josto-me/clutch-slip-monitor/hardware/cdi-rpm/cdi-rpm-layout.pdf

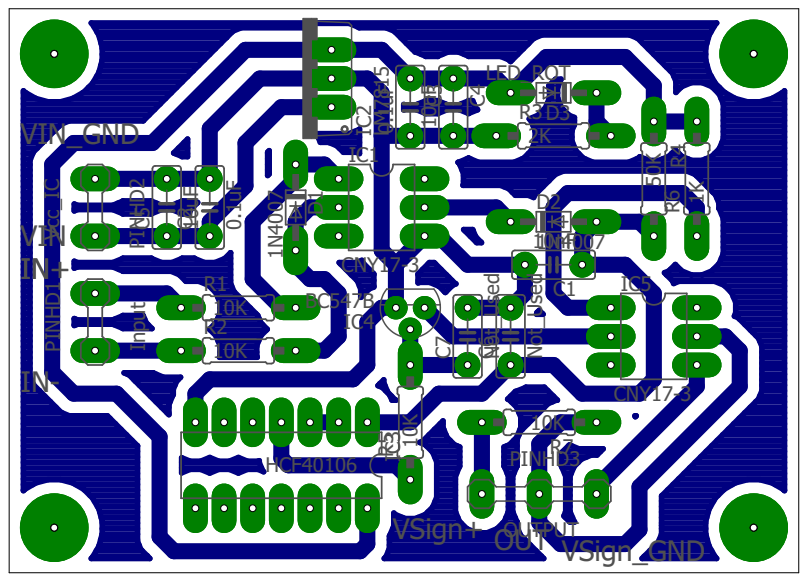
[picture p1: page 1]
