josto-me/clutch-slip-monitor/hardware/cdi-rpm/cdi-rpm-schematic.pdf

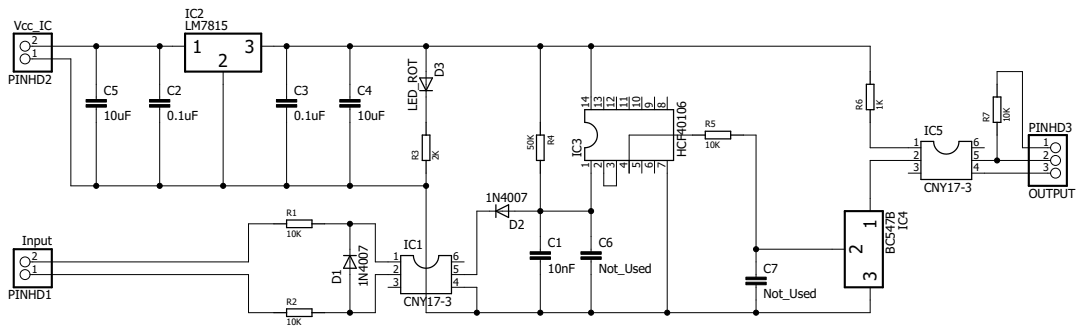
[picture p2: page 1]
