josto-me/clutch-slip-monitor/hardware/ignition-amplifier/ignition-amplifier-layout.pdf

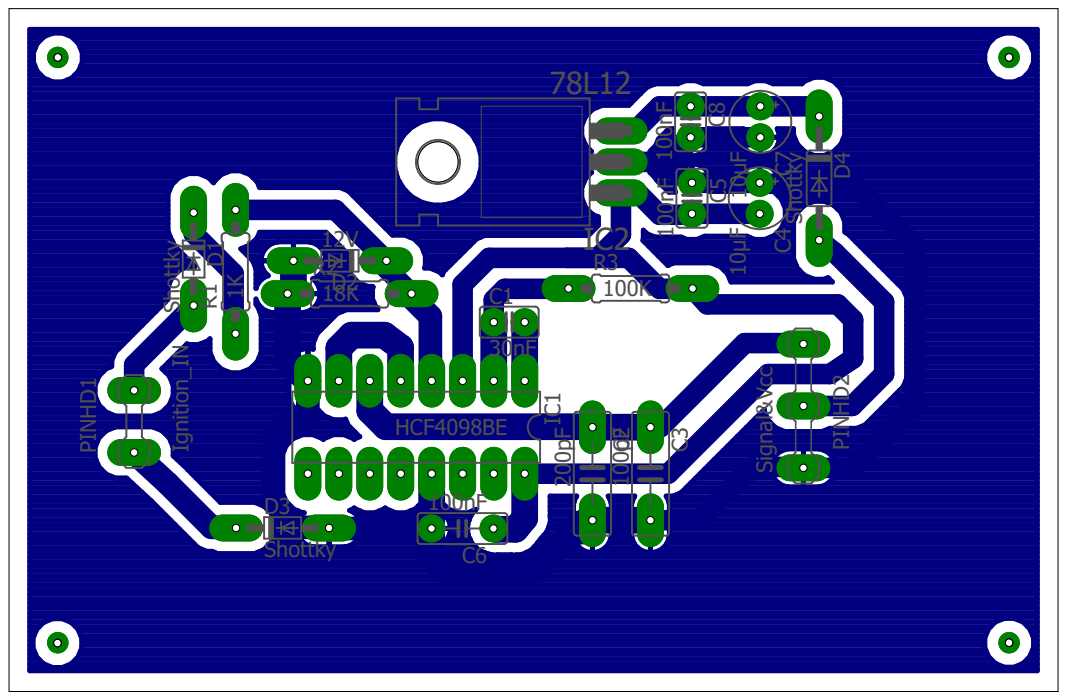
[picture p3: page 1]
