josto-me/clutch-slip-monitor/hardware/ignition-amplifier/ignition-amplifier-schematic.pdf

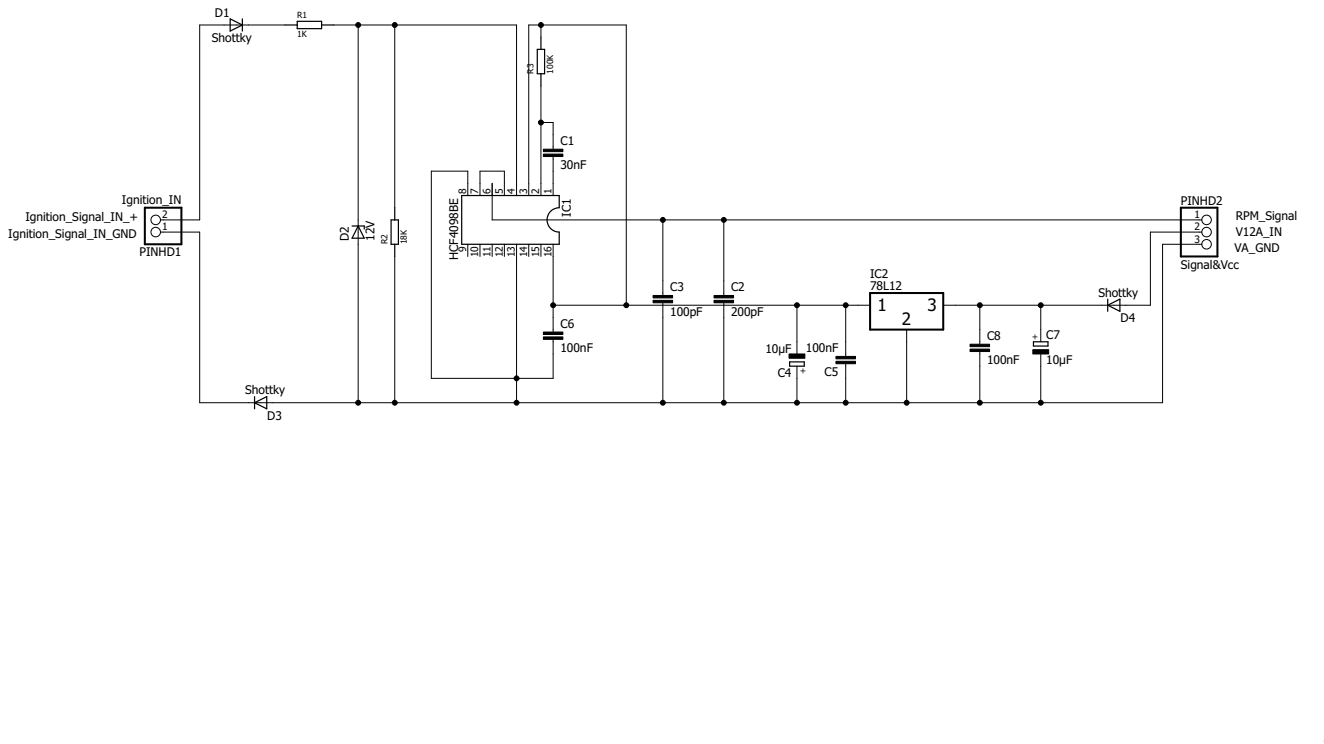
[picture p4: page 1]
