josto-me/clutch-slip-monitor/hardware/signal-conditioning/signal-conditioning-layout.pdf

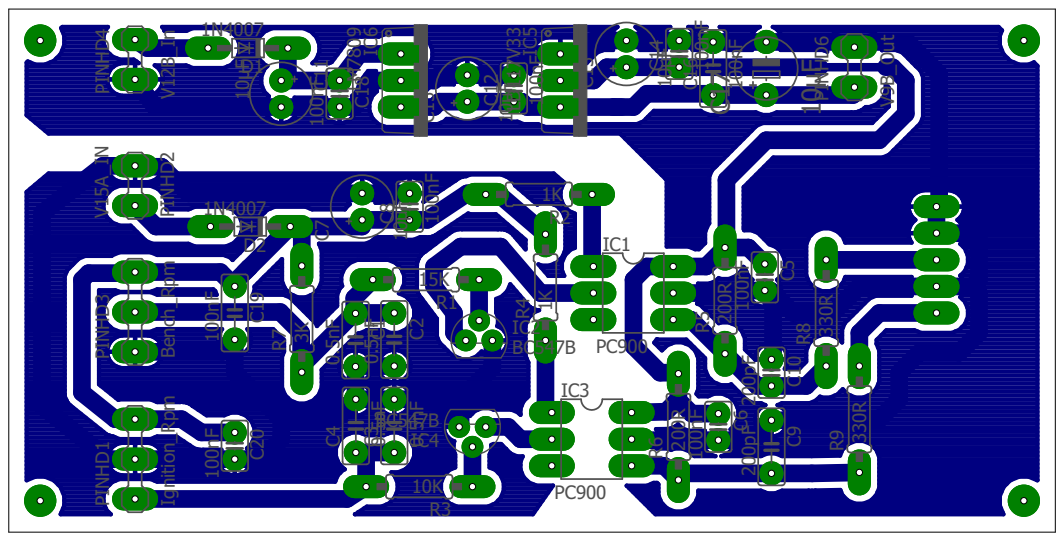
[picture p5: page 1]
