josto-me/clutch-slip-monitor/hardware/signal-conditioning/signal-conditioning-schematic.pdf

1
2

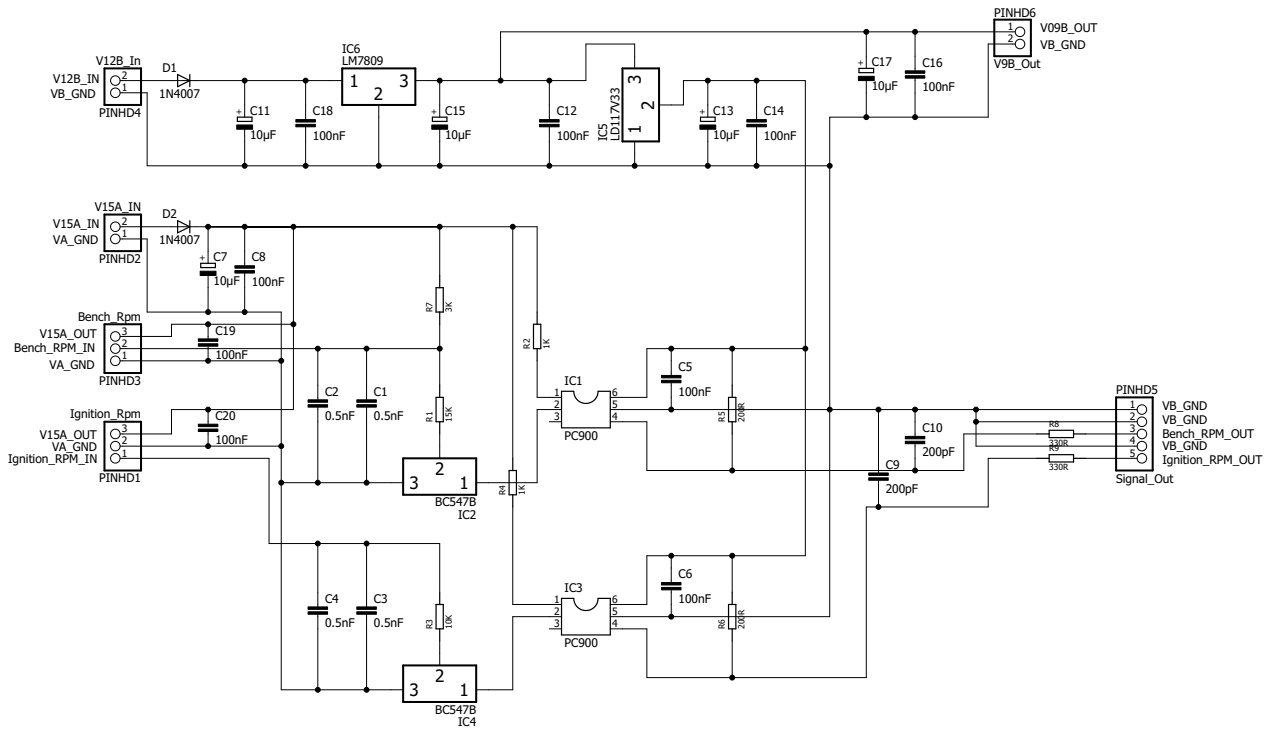
[picture p6: page 1]
