josto-me/clutch-slip-monitor/(notices)

Notices in the files:
README.md:
Docs: CC BY 4.0
